physiii/glass-break/screenshots/layout.png

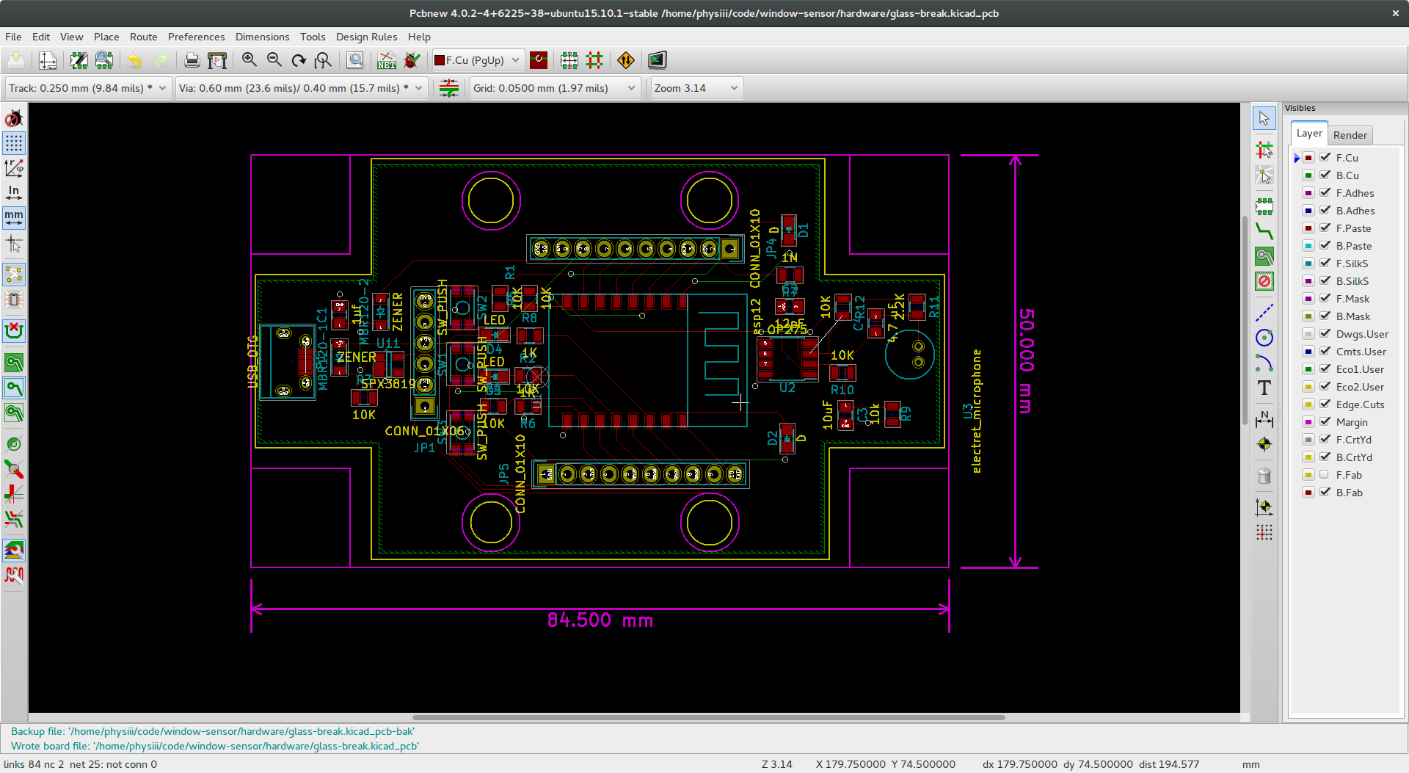
screenshots/layout.png
