physiii/glass-break/screenshots/window-sensor-schematic.pdf

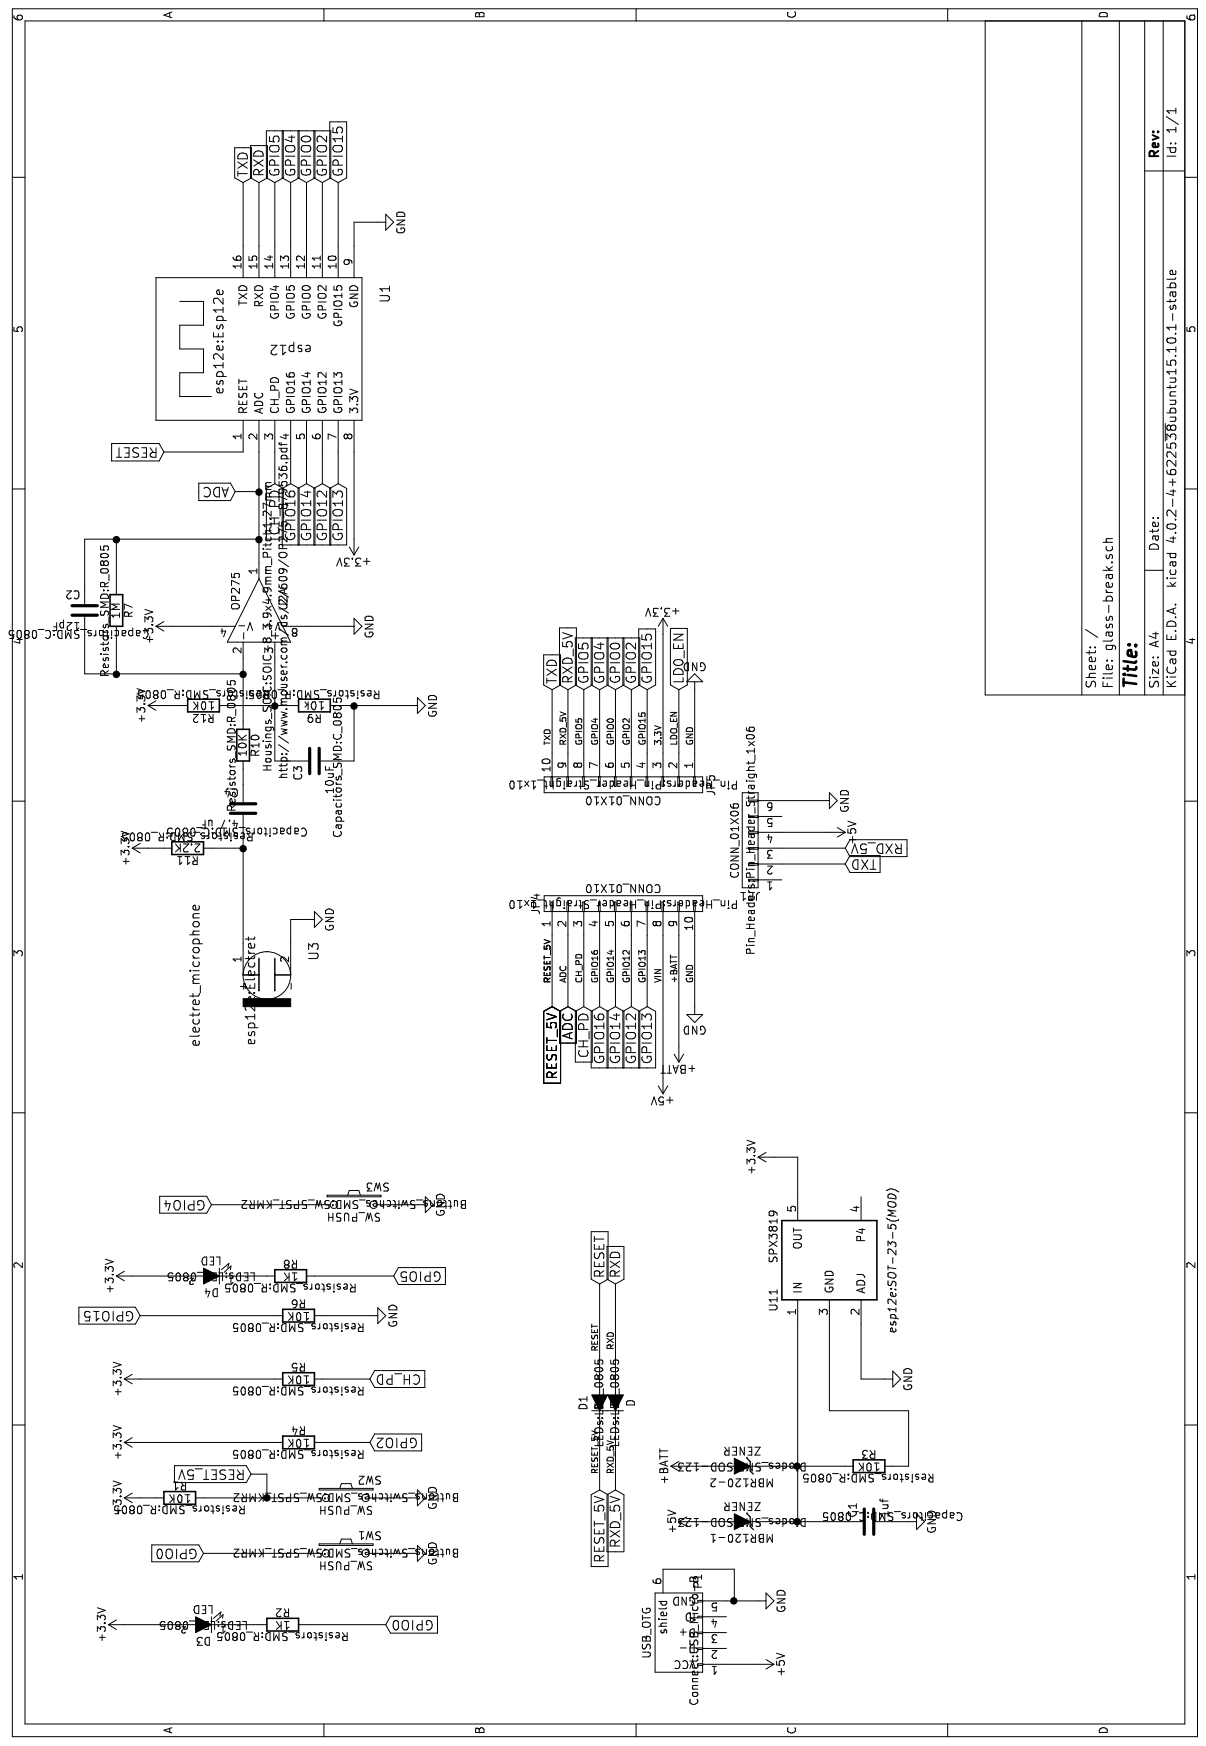
[picture p2: page 1]
