physiii/glass-break/hardware/window-sensor.kicad_pcb

## KiCad design hardware/window-sensor.kicad_pcb (2016-03-31)

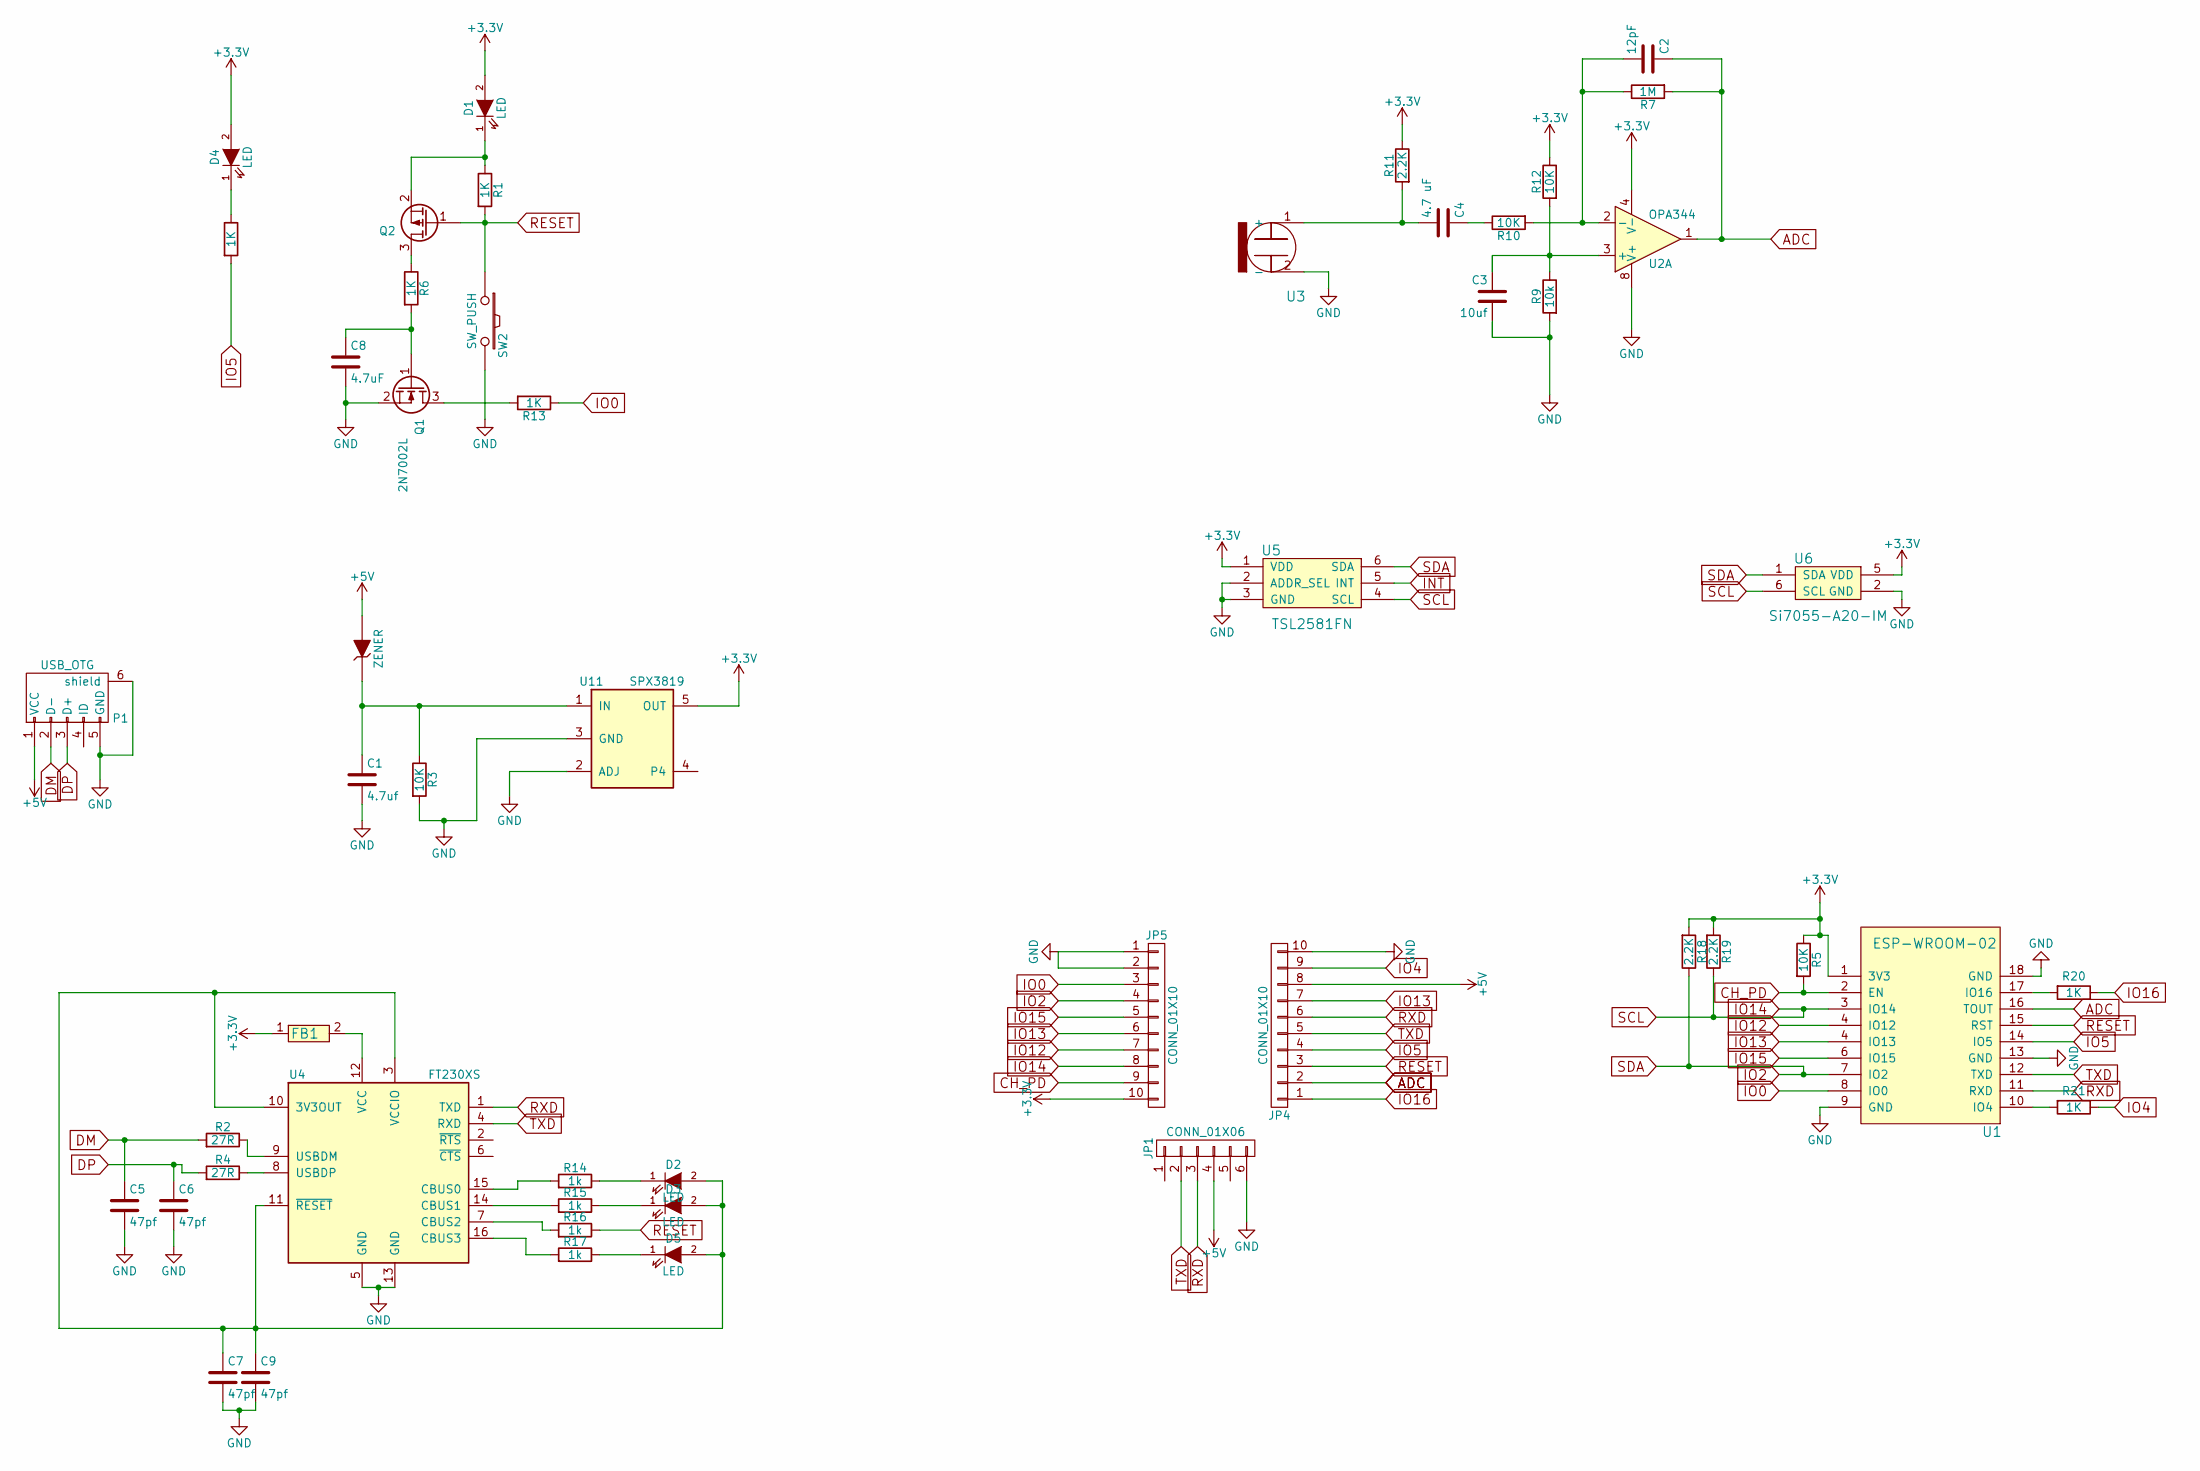
[picture p7: schematic window-sensor.sch]

Parts:
C1: 4.7uf; C_0805; Part Number VJ0805G475KXYTW1BC
C2: 12pF; R_0603; Part Number GRM0335C1H120GA01D
C3: 10uf; C_0805; Part Number VJ0805G106KXQTW1BC
C4: 4.7 uF; C_0805; Part Number C0603X5R1C472K030BA
C5, C6, C7, C9: 47pf; C_0603; Part Number VJ0603A470JXACW1BC
C8: 4.7uF; C_0805; Part Number VJ0805G475KXYTW1BC
D1, D2, D3, D4, D5: LED; LED_0805; Part Number LS Q976-NR-1
FB1: BLM18PG330SN1D; R_0603; Part Number BLM18PG330SN1D
JP1: CONN_01X06; Pin_Header_Straight_1x06
JP4, JP5: CONN_01X10; Pin_Header_Straight_1x10
MBR120-1: ZENER; SOD-123; Part Number MBR120VLSFT1G
P1: USB_OTG; USB_Micro-B; Part Number 10118194-0001LF
Q1: 2N7002L; SOT-23; Part Number 2N7002L
Q2: BSS84LT1G; SOT-23; Part Number BSS84LT1G
R1, R6, R8, R13, R20, R21: 1K; R_0603; Part Number ERJ-3EKF1001V
R2, R4: 27R; R_0603; Part Number ERJ-3GEYJ270V
R3, R5, R10, R12: 10K; R_0603; Part Number ERJ-3GEYJ103V
R7: 1M; R_0603; Part Number ERJ-3GEYJ105V
R9: 10k; R_0603; Part Number ERJ-3GEYJ103V
R11, R18, R19: 2.2K; R_0603; Part Number ERJ-3GEYJ222V
R14, R15, R16, R17: 1k; R_0603; Part Number ERJ-3EKF1001V
SW2: SW_PUSH; SW_SPST_KMR2; Part Number KMR211NG LFS
U1: ESP-WROOM-02; Part Number ESP-WROOM-02
U2: OPA344; SOIC-8_3.9x4.9mm_Pitch1.27mm; Part Number OPA344NA/3K
U3: CMC-5044PF-A; Electret; Part Number CMC-5044PF-A
U4: FT230XS; SSOP-16_3.9x4.9mm_Pitch0.635mm; Part Number FT230XS
U5: TSL2581FN; DFN-6-1EP_2x2mm_Pitch0.65mm; Part Number TSL2581FN
U6: Si7055-A20-IM; DFN-6-1EP_3x3mm_Pitch0.95mm; Part Number Si7055-A20-IM
U11: SPX3819; SOT-23-5; Part Number ERJ-3GEYJ103V

Connections:
+3V3: D1.2 (A), D4.2 (A), FB1.1, JP5.10, R5.1, R11.1, R12.1, R18.2, R19.2, U1.1 (3V3), U2.4 (V-), U5.1 (VDD), U6.5 (VDD), U11.5 (OUT)
+5V: JP1.4, JP4.8, MBR120-1.2 (A), P1.1 (VCC)
ADC: C2.1, JP4.2, R7.2, U1.16 (TOUT), U2.1
CH_PD: JP5.9, R5.2, U1.2 (EN)
DM: C5.1, P1.2 (D-), R2.2
DP: C6.1, P1.3 (D+), R4.2
GND: C1.2, C3.2, C5.2, C6.2, C7.2, C8.2, C9.2, JP1.6, JP4.10, JP5.1, JP5.2, P1.5 (GND), P1.6 (shield), Q1.2 (S), R3.2, R9.2, SW2.2, U1.9 (GND), U1.13 (GND), U1.18 (GND), U2.8 (V+), U3.2 (-), U4.5 (GND), U4.13 (GND), U5.2 (ADDR_SEL), U5.3 (GND), U6.2 (GND), U11.2 (ADJ), U11.3 (GND)
INT: U5.5 (INT)
IO0: JP5.3, R13.1, U1.8 (IO0)
IO2: JP5.4, R18.1, U1.7 (IO2), U5.6 (SDA), U6.1 (SDA)
IO4: JP4.9, R21.1
IO5: JP4.4, R8.2, U1.14 (IO5)
IO14: JP5.8, R19.1, U1.3 (IO14), U5.4 (SCL), U6.6 (SCL)
IO15: JP5.5, U1.6 (IO15)
IO16: JP4.1, R20.1
unnamed: C1.1, MBR120-1.1 (K), R3.1, U11.1 (IN)
unnamed: C2.2, R7.1, R10.2, U2.2 (-)
unnamed: C3.1, R9.1, R12.2, U2.3 (+)
unnamed: C4.1, R10.1
unnamed: C4.2, R11.2, U3.1 (+)
unnamed: C7.1, C9.1, D2.2 (A), D3.2 (A), D5.2 (A), U4.3 (VCCIO), U4.10 (3V3OUT), U4.11 (~RESET)
unnamed: C8.1, Q1.1 (G), R6.2
unnamed: D1.1 (K), Q2.2 (S), R1.1
unnamed: D2.1 (K), R14.1
unnamed: D3.1 (K), R15.1
unnamed: D4.1 (K), R8.1
unnamed: D5.1 (K), R17.1
unnamed: FB1.2, U4.12 (VCC)
unnamed: Q1.3 (D), R13.2
unnamed: Q2.3 (D), R6.1
unnamed: R2.1, U4.9 (USBDM)
unnamed: R4.1, U4.8 (USBDP)
unnamed: R14.2, U4.15 (CBUS0)
unnamed: R15.2, U4.14 (CBUS1)
unnamed: R16.2, U4.7 (CBUS2)
unnamed: R17.2, U4.16 (CBUS3)
unnamed: R20.2, U1.17 (IO16)
unnamed: R21.2, U1.10 (IO4)
RESET: JP4.3, Q2.1 (G), R1.2, R16.1, SW2.1, U1.15 (RST)
RXD: JP1.3, JP4.6, U1.11 (RXD), U4.1 (TXD)
TXD: JP1.2, JP4.5, U1.12 (TXD), U4.4 (RXD)

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
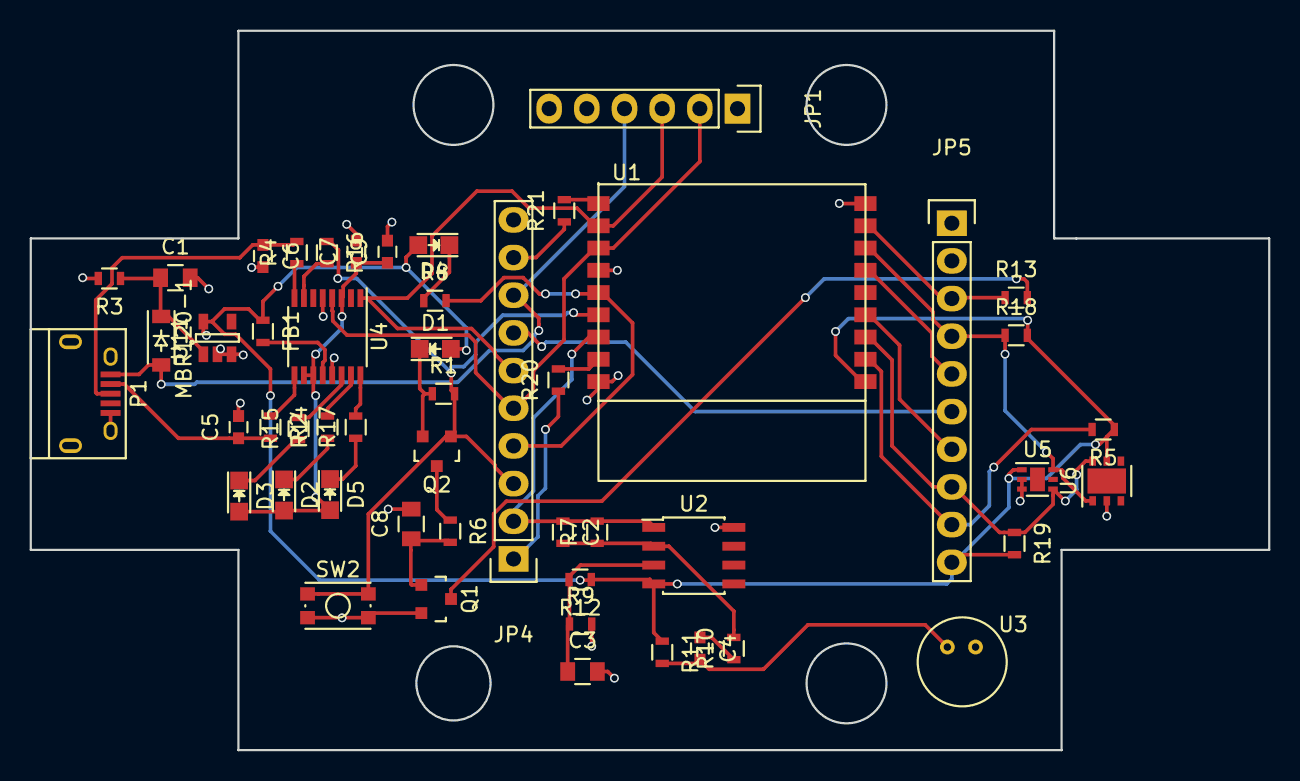
[picture p8: board window-sensor.kicad_pcb from above]

Board: 2 copper layers, 83.5 x 48.5 mm, 51 parts (0 on the bottom side), 42 nets.
