physiii/glass-break/(commit log)

2015-12-28 added schematic components
    [glass-break.sch]
2016-01-08 schematic update
    [_saved_glass-break.sch]
2016-02-19 sch update
    [HackRF_One_Case.dxf, HackRF_One_Case_With_Button_CutOuts.dxf, SoBv1_HackRF_One_Bottom2D.skp, SoBv1_HackRF_One_Top2D+HackRF_OneTOP.skp, SoBv1_HackRF_One_Top2D.skp, _saved_hackrf-one.sch, baseband.sch, frontend.sch]
2016-03-05 layout update
    [glass-break.sch]
2016-03-05 added dimensions update
    [glass-break.kicad_pcb]
2016-03-08 footprint update
    [glass-break.kicad_pcb, glass-break.sch]
2016-03-08 pcd update
    [glass-break.kicad_pcb, glass-break.sch]
2016-03-09 PCB attempt
    [glass-break.kicad_pcb, glass-break.sch]
2016-03-10 pcb trial2
    [glass-break.kicad_pcb]
2016-03-10 pcb 3
    [glass-break.kicad_pcb]
